djordjevujic/running-mouse-pmf/README.md

# running-mouse-pmf
Project for testing mouse/rats activity and logging data into a csv file on the SD card

## SD card library
https://github.com/greiman/SdFat

## DS3231 library
http://www.rinkydinkelectronics.com/library.php?id=73
