djordjevujic/running-mouse-pmf/05_docs/supporting/console_output/Cycles.PNG

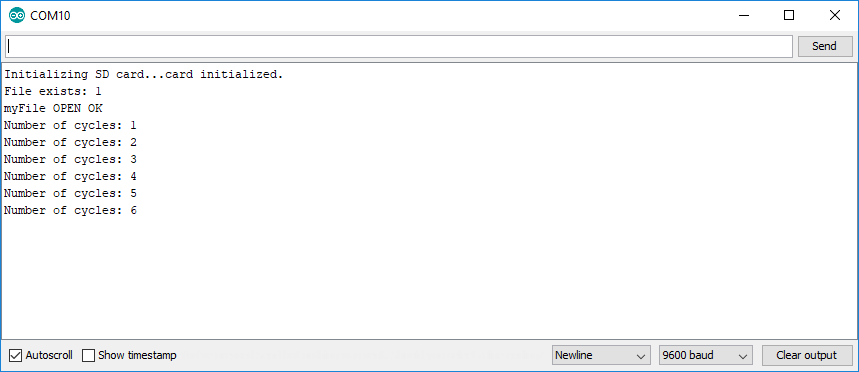
05_docs/supporting/console_output/Cycles.PNG
