djordjevujic/running-mouse-pmf/02_hw/mouse_wheel_v1/Mouse-Wheel-Project.pdf

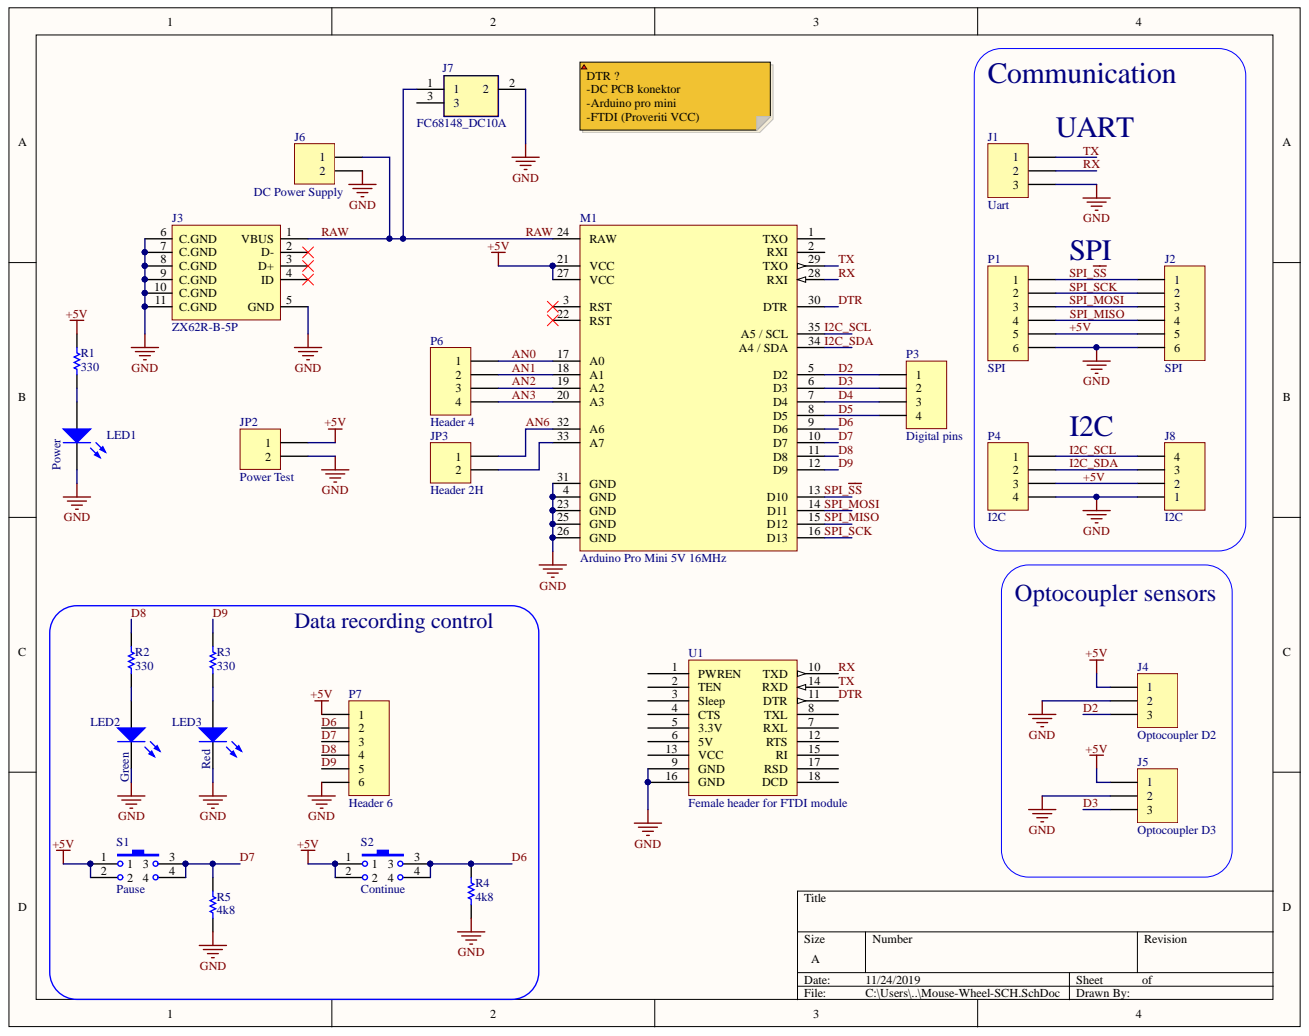
[picture p7: page 1]

AN2 | A2 19 | D3
AN3 | A3 20 | D4
AN6 | A6 32 | D5

Female header for FTDI module

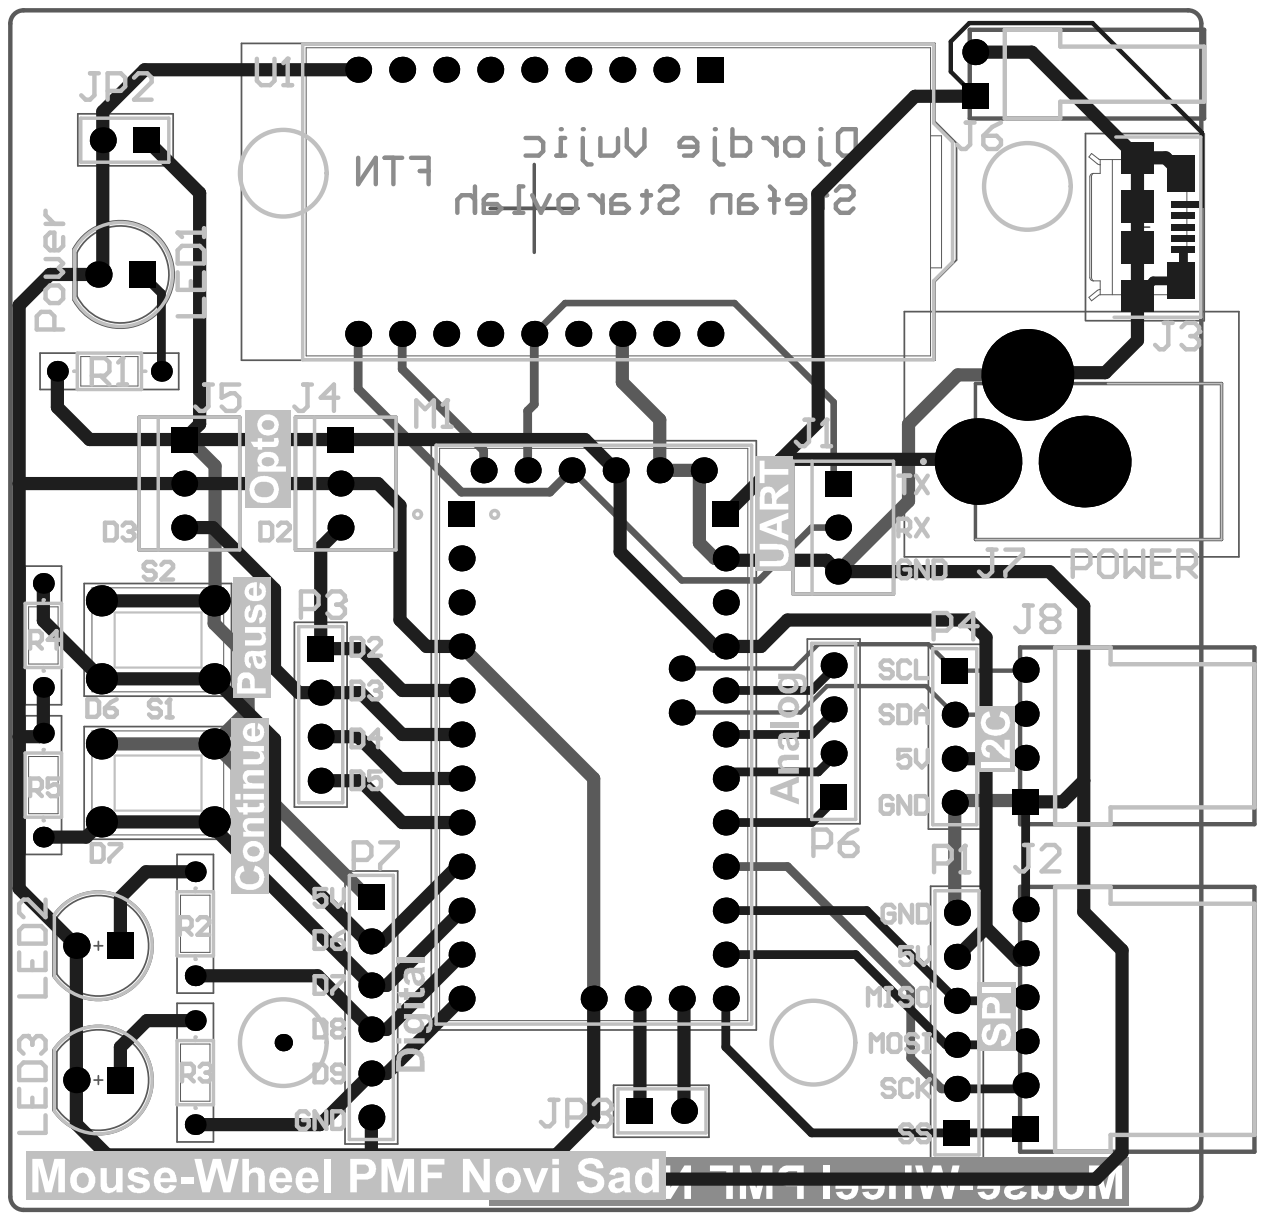
[picture p8: page 2]
