djordjevujic/running-mouse-pmf/(list of files, drawings)

Other design files:
02_hw/mouse_wheel_v1/Mouse-Wheel-Project.PrjPCB
02_hw/mouse_wheel_v1/Mouse-Wheel-SCH.SchDoc
02_hw/mouse_wheel_v2/Mouse-Wheel-v2-Project.PrjPCB
02_hw/mouse_wheel_v2/Mouse-Wheel-v2-SCH.SchDoc
