djordjevujic/running-mouse-pmf/03_tests/rtc_test.ino

// DS3231_Serial_Easy
// Copyright (C)2015 Rinky-Dink Electronics, Henning Karlsen. All right reserved
// web: http://www.RinkyDinkElectronics.com/
//
// Arduino Uno/2009:
// ----------------------
// DS3231:  SDA pin   -> Arduino Analog 4 or the dedicated SDA pin
//          SCL pin   -> Arduino Analog 5 or the dedicated SCL pin
//
//
// The internal pull-up resistors will be activated when using the 
// hardware I2C interfaces.
//
// You can connect the DS3231 to any available pin but if you use any
// other than what is described above the library will fall back to
// a software-based, TWI-like protocol which will require exclusive access 
// to the pins used, and you will also have to use appropriate, external
// pull-up resistors on the data and clock signals.
//

#include <DS3231.h>

// Init the DS3231 using the hardware interface
DS3231  rtc(SDA, SCL);
struct myDate
{
  int input_seconds;
  int input_minutes;
  int input_hours;
  int input_day;
  int input_month;
  int input_year;  
};



myDate input_date;

void setup()
{
  // Setup Serial connection
  Serial.begin(115200);
  // Uncomment the next line if you are using an Arduino Leonardo
  //while (!Serial) {}
  
  // Initialize the rtc object
  rtc.begin();
  
  // The following lines can be uncommented to set the date and time
  rtc.setDOW(SUNDAY);     // Set Day-of-Week to SUNDAY

  //Setting time
 

  
 // rtc.setTime(13,39,0);     // Set the time to 12:00:00 (24hr format)
  //rtc.setDate(22, 10, 2017);   // Set the date to January 1st, 2014

  //loading time
  
}

void loop()
{
  
  // Send Day-of-Week
  Serial.print(rtc.getDOWStr());
  Serial.print(" ");
  
  // Send date
  Serial.print(rtc.getDateStr());
  Serial.print(" -- ");

  // Send time
  Serial.println(rtc.getTimeStr());
  
  // Wait one second before repeating :)
  delay (1000);
}
