djordjevujic/running-mouse-pmf/(commit log)

2017-10-21 MH opto sensor tested. Interrupt routine with debouncing implemented. Works fine.
2017-10-24 File creating bug fixed. Return in dateStringPreparation(). Debugging version
    [test-all-in-one.ino]
2017-10-26 All in loop implemented. TOFIX: if arduino turned off, then not log in that time interval, that is already logged
2017-10-27 Fixed: Data cannot log if there is data with same hours and minutes in file. This is in case of power losing. TODO: Serial communication with windows PC
    [test-all-in-one.ino]
2017-10-30 Test: imported warning led blinking function if SD card is not inserted
2018-01-05 Imported led_blink function
2019-11-24 pcbs and schematics
    pcbs and chematics updated for both versions
    [Mouse-Wheel-Project.PrjPCB, Mouse-Wheel-SCH.SchDoc, Mouse-Wheel-v2-Project.PrjPCB, Mouse-Wheel-v2-SCH.SchDoc]
2019-11-28 Create interrupts.ino
    interrupts template
2019-11-28 hw project files update
    [Mouse-Wheel-Project.PrjPCB, Mouse-Wheel-v2-Project.PrjPCB]
2019-11-28 DS3231 library inserted for backup reasons
2019-12-13 1st file parsed
    [measurement_example.csv]
